JamesGlanville/datalogger/README.md

# Package Condition Tracking System

Data logger designed to track the conditions of a parcel in transit.

It keeps track of:
* Temperature
* Humidity
* Shocks and impacts
* Orientation

Designed and built for SB3 Data Logger project.
