JamesGlanville/datalogger/Reports/Final_Report_Andy.org

** Parcel tracker:

+ http://www.sciencedaily.com/releases/2011/06/110608123143.htm
+ FedEx tracker (Sensor-based-logistics):
  http://www.senseaware.com/
+ who benefits from this type of tracking
  http://www.senseaware.com/who-benefits/
+ worldwide release Nov 2012 - limited in available couriers.
  http://news.van.fedex.com/SenseAware

+ military application:
  http://www.almc.army.mil/alog/issues/JulAug08/enhancelog_w_sensortech.html

+ for container tracking, not parcel based
  http://www.scantec.de/en/knowledge-base/hi-q-news/2010/wireless-sensor-networks-fuer-die-logistik.html

+ Cambridge consultants development
  http://www.cambridgeconsultants.com/news/pr/release/116/en
  
+ Nasa payload tracker (spinoff)
  http://spinoff.nasa.gov/spinoff2000/t1.htm

** RS232 driver
+ http://www.teuniz.net/RS-232/
