JamesGlanville/datalogger/3DAQ/Documentation/cap-humidity-sensor-circuit_files/image001.gif

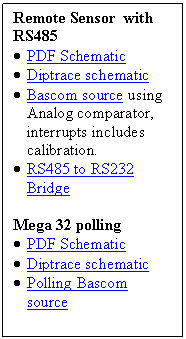
3DAQ/Documentation/cap-humidity-sensor-circuit_files/image001.gif
