JamesGlanville/datalogger/3DAQ/Documentation/cap-humidity-sensor-circuit_files/image003.jpg

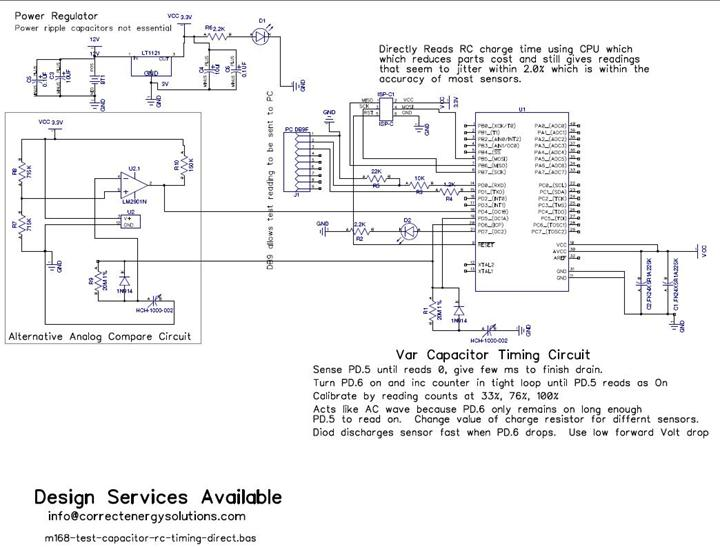
3DAQ/Documentation/cap-humidity-sensor-circuit_files/image003.jpg
