JamesGlanville/datalogger/Reports/humid_calib_freezer.jpg

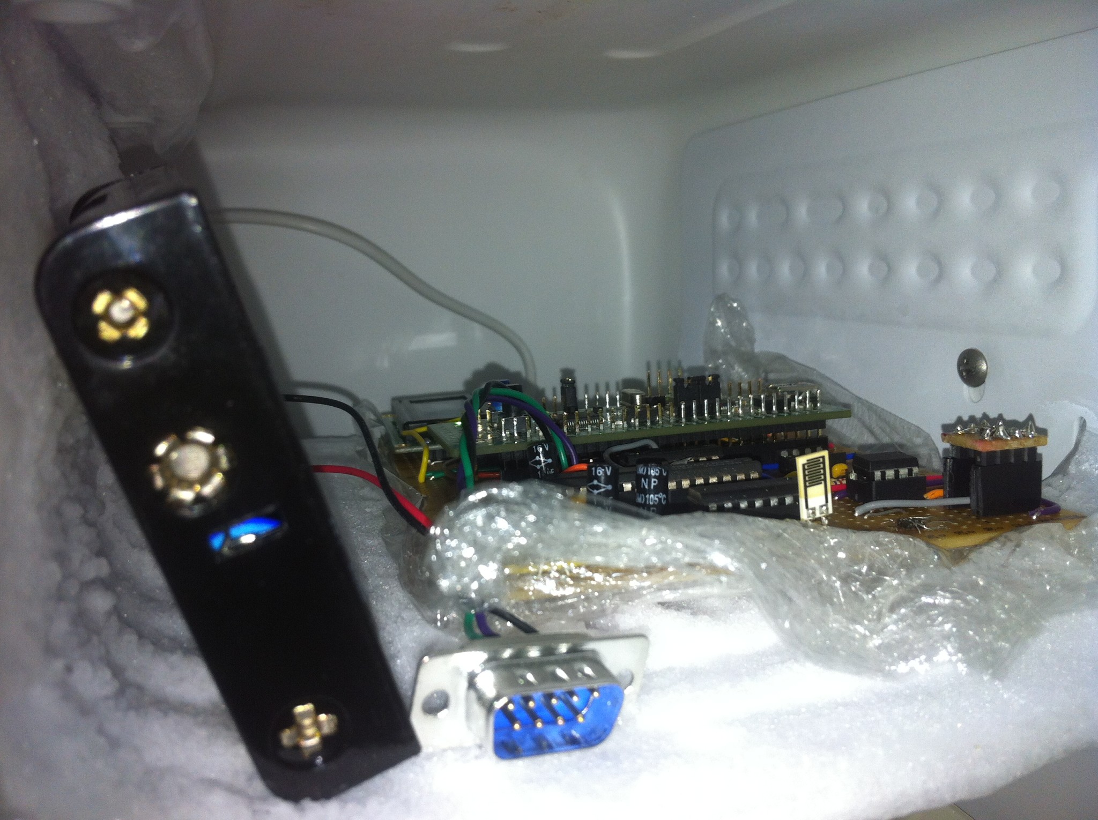
Reports/humid_calib_freezer.jpg
