JamesGlanville/datalogger/Schematics/Thermistor Cond.png

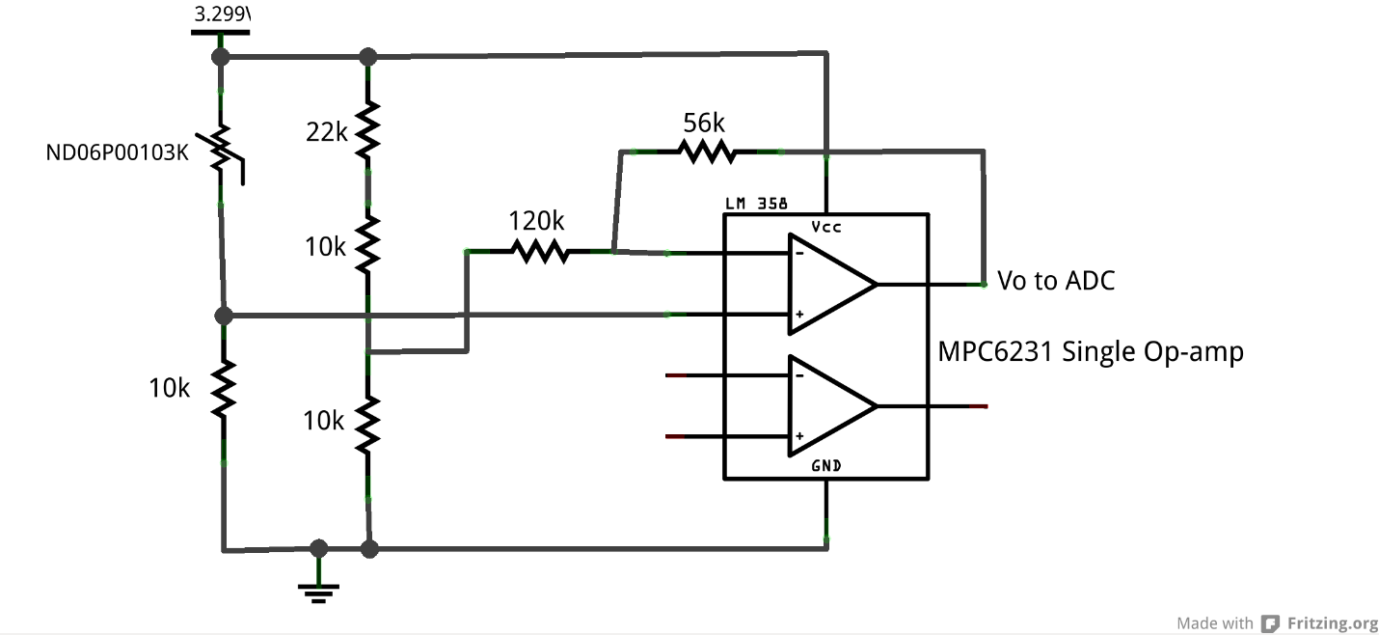
Schematics/Thermistor Cond.png
