JamesGlanville/datalogger/Schematics/Thermistor Conditioning_schem.png

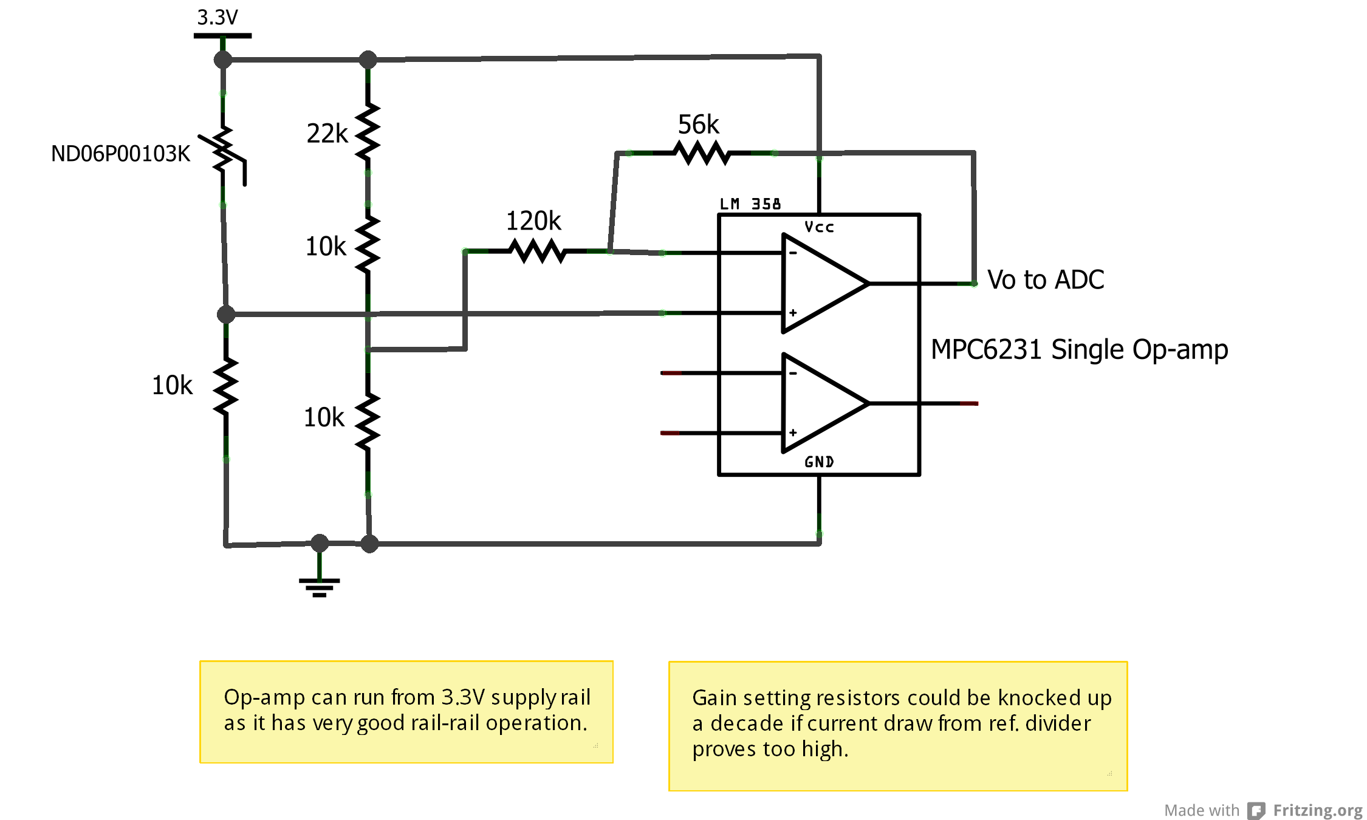
Schematics/Thermistor Conditioning_schem.png
