JamesGlanville/datalogger/(list of files, cad)

Other CAD files:
gui/vc_msw/datalogger/rs232.obj
gui/vc_mswd/datalogger/comms.obj
gui/vc_msw/datalogger/datalogger.obj
gui/vc_mswd/datalogger/rs232.obj
gui/vc_mswd/datalogger/datalogger.obj
