JamesGlanville/datalogger/3DAQ/Documentation/M16_humidity_sensor_HCH-1000-002.dch.pdf

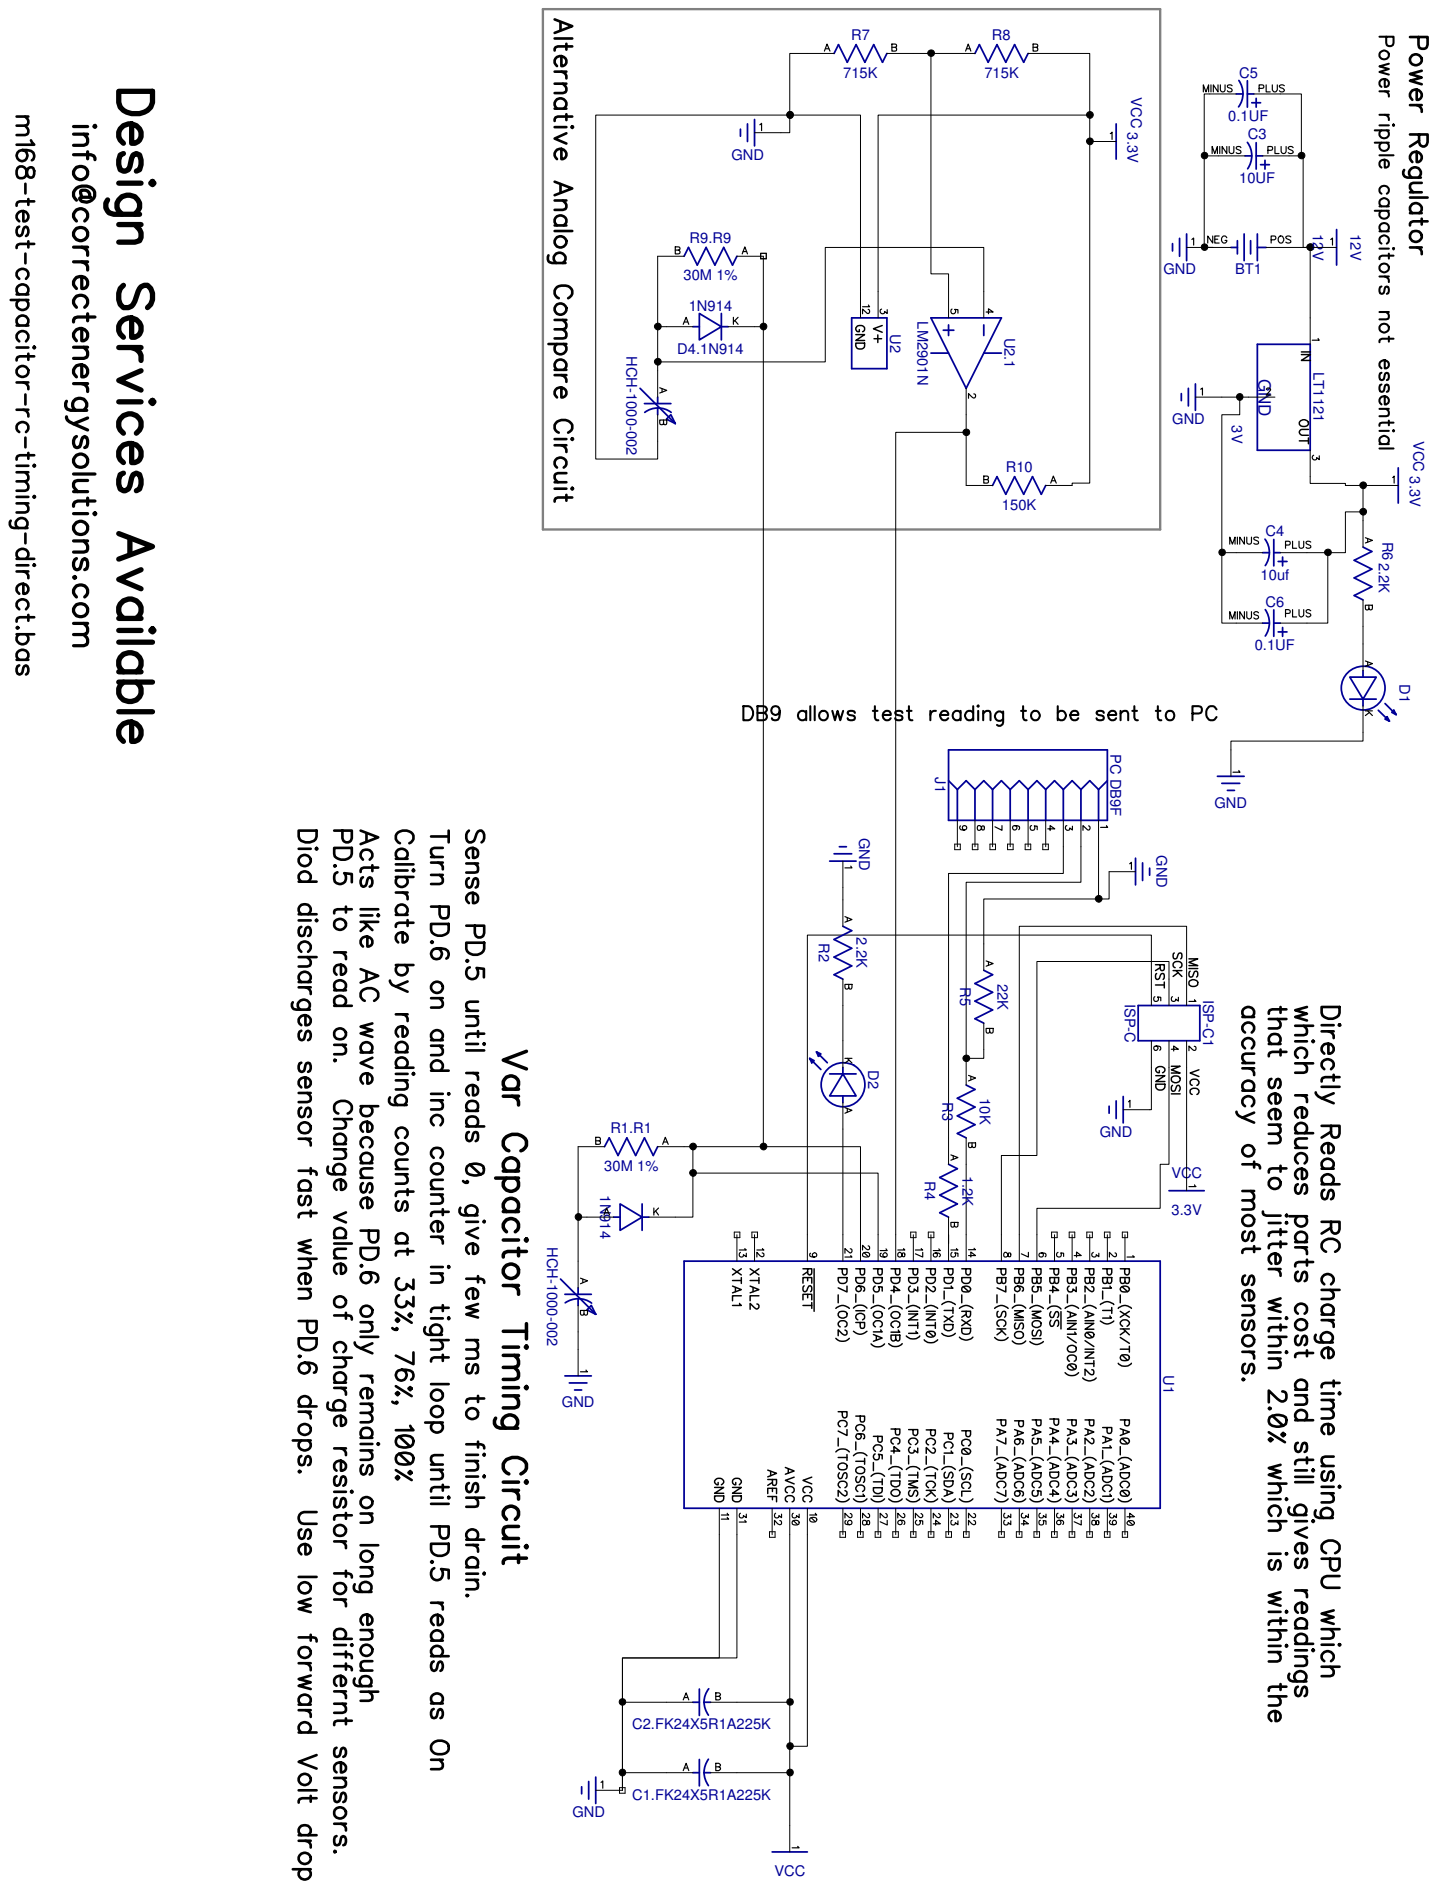
[picture p24: page 1]
