JamesGlanville/datalogger/(list of files, drawings)

Other design files:
Schematics/humiditysensor.fzz
Schematics/i2c.fzz
Schematics/power.fzz
Schematics/Thermistor Conditioning nonotes.fzz
Schematics/Thermistor Conditioning.fzz
