JamesGlanville/datalogger/3DAQ/Firmware/user/src/main.c

#include "stm32F10x.h"
#include "LEDs.h"
#include "UART.h"
#include "ADC.h"
#include "stm32F10x_i2c.h"
#include "stm32f10x_gpio.h"
#include "stm32f10x_rcc.h"
#include "stm32f10x_tim.h"
#include "LCD.h"
#include "humidity.h"
#include "webi2c.h"
#include "timer.h"

#define WAITING		1
#define LOGGING		2
#define UPLOADING	3
#define ERASING		4
#define STREAMING	5

volatile int currentstate=WAITING;

//Hardware:

//LED3 is connected to PC9 (active high)
//Test circuit should have potentiometer connected to PC0 for analogue sampling
//UART TX and RX pins are PA9 and PA10 respectively (with MAX232 interface)

//Firmware:

//User files that can be modified/replaced
//LEDs.c and LEDs.h - functions to control LED on dev board
//ADC.c and ADC.h - functions to initalise ADC and take samples from it
//UART.c and UART.h - functions to initialise and use UART for serial RS232 comms with PC

//Standard includes that should not be modified
//startup_stm32f10x_md_vl.s - startup file (in assembler) that intialises the MCU before it enters main()
//core_cm3.c - definitions specific to the ARM Cortex M3 core
//system_stm32f10.c and stm32f10x.h - functions and definitions specific to the STM32F10x series

//There are also a number of Standard Peripheral Library files that should not be modified (additional SPL files can be included if needed, see "Firmware/lib" folder)

//Software:
//This firmware works with the Labwindows/CVI demonstration appllication sofwtare

//------------------------------------------------------------------------------

//Global variables

//Command from UART
volatile unsigned int LEDbyte=1;

volatile int command_flag;
volatile int value;
volatile int value_received;

//ADC variables
volatile uint8_t new_data;

uint8_t LogBuffer[ENTRYBYTES];

//------------------------------------------------------------------------------

//Function prototypes for functions in main.c file

void check_and_process_received_command(void);

//------------------------------------------------------------------------------

//Main function (execution starts here after startup file)
int main(void)
{
	int i;
	int e;
	uint16_t temperature;

	init_GPIO_pins();
	
	//Short delay during which we can communicate with MCU via debugger even if later user code causes error such as sleep state with no wakeup event that prevents debugger interface working
	//THIS MUST COME BEFORE ALL USER CODE TO ENSURE CHIPS CAN BE REPROGRAMMED EVEN IF THEY GET STUCK IN A SLEEP STATE LATER
	for (i = 0; i < 1000000; i++)
	{
		LED_on();
	}
	
	GPIO_Init_Mode(GPIOA,GPIO_Pin_0,GPIO_Mode_IN_FLOATING); //User button.
	GPIO_Init_Mode(GPIOC,GPIO_Pin_11,GPIO_Mode_IN_FLOATING); //Accelerometer interrupt.
	delay_init();
	LED_off();
	LCDINIT();
	home();
	clear();
	display(); //Surely some of these can be commented out.
	noCursor();
	noBlink();

	standby();

	UART_init();
	humidity_init();
	ADC_init();
	I2C_EEPROM();
	I2C_ACCEL_INIT();
	I2C_EE_LoadConfig();
	logging_timer_init();
	
//	I2C_EE_BufferWrite(Test_Buffer, EEPROM_WriteAddress1, 100);
//I2C_EE_BufferRead(buffer, 0, 100);

	/*while(1){
		if(LEDbyte==512){LEDbyte=1;}
		else {LEDbyte=LEDbyte<<1;}
		setLEDS();
		
	setCursor(0,1);
	temperature=getTemperature();
	writenumber( temperature/100);
	write('.');
	writenumber((temperature/10)%10);
		write(' ');

		write(0xDF);
	write('C');
	setCursor(0,0);
	writenumber(readhumidity(24)); //Needs real temperature
	write(' ');
	write('%');
	write('R');
	write('H');
		delay_ms(50);
		
		check_and_process_received_command();
		
	}*/
	//currentstate=UPLOADING;

	while(1)
	{
		switch (currentstate){
			
		case WAITING:
			if (GPIO_ReadInputDataBit(GPIOA,GPIO_Pin_0)) //Polling is probably ok here, since the loop will be very very fast.
			{
				currentstate=LOGGING;
				clear();
				write('S');
				write('t');
				write('a');
				write('r');
				write('t');
				write('i');
				write('n');
				write('g');
				delay_ms(2000);
				clear();
				I2C_EE_StartLog();
				TIM4->CNT=0;
			}
			break;

		case LOGGING:
			if (GPIO_ReadInputDataBit(GPIOA,GPIO_Pin_0)){currentstate=WAITING;I2C_EE_FinishLog();break;} //Polling is probably ok here, since the loop will be very very fast.
			LEDbyte|= 1<<8;
			setLEDS();
			if (TIM_GetFlagStatus(TIM3, TIM_FLAG_Update) != RESET)
			{
				TIM_ClearFlag(TIM3, TIM_IT_Update);
				temperature = getTemperature();
				LogBuffer[0]=(temperature>>8)&0xFF;
				LogBuffer[1]=temperature&0xFF;
				LogBuffer[2]=readhumidity(LogBuffer[0]);
				I2C_ACCEL_READ();
				I2C_EE_Log(LogBuffer);
				setCursor(0,1);
				writenumber(temperature/100);
				write('.');
				writenumber(temperature%100);
				write(' ');
				write(0xDF);
				write('C');
				write(' ');
				setCursor(0,0);
				writenumber(25); //Needs real temperature
				write(' ');
				write('%');
				write('R');
				write('H');
				write(' ');
				LEDbyte&= ~(1<<8);
				setLEDS();
			}
			break;
		
		case UPLOADING:
			currentstate=WAITING;
			I2C_EE_Upload();
			break;
		
		case ERASING:
			currentstate=WAITING;
			I2C_EE_Erase();
			break;
		
		case STREAMING:
			if (TIM_GetFlagStatus(TIM3, TIM_FLAG_Update) != RESET)
			{
				TIM_ClearFlag(TIM3, TIM_IT_Update);
				temperature = getTemperature();
				LogBuffer[0]=(temperature>>8)&0xFF;
				LogBuffer[1]=temperature&0xFF;
				LogBuffer[2]=readhumidity(LogBuffer[0]);
				I2C_ACCEL_READ();
//				I2C_EE_Log(LogBuffer);
				for (e=0;i<ENTRYBYTES;i++)
				{
					UART_send_byte(LogBuffer[e]);
				}
				setCursor(0,1);
				writenumber(temperature/100);
				write('.');
				writenumber(temperature%100);
				write(' ');
				write(0xDF);
				write('C');
				write(' ');
				setCursor(0,0);
				writenumber(25); //Needs real temperature
				write(' ');
				write('%');
				write('R');
				write('H');
				write(' ');
				LEDbyte&= ~(1<<8);
				setLEDS();
			}
		break;
		}
		
		
	}
}


/*
//------------------------------------------------------------------------------

//Other functions

//Simple function to check for and process one of two received commands from PC via global varoable flags
void check_and_process_received_command(void)
{
	uint16_t ADC_word;
	uint8_t byte1, byte2;
	
	//Check for a receievd (non-zero) command flag from the PC
	if (command_flag == 1)
	{
		//An ADC sample command has been received
		
		//Perform an ADC conversion
		ADC_word = ADC_perform_single_conversion();
		
		//Put the 12-bit result into 2 bytes
		byte1 = (uint8_t)((ADC_word >>8) & 0xFF);
		byte2 = (uint8_t)((ADC_word >>0) & 0xFF);
		
		//Send the message (command flag followed by two bytes with the analogue value)
		UART_send_byte(1);
		UART_send_byte(byte1);
		UART_send_byte(byte2);
		
		//Reset command flag
		command_flag = 0;
	}
	else if (command_flag == 2)
	{
		//An LED command has been received
		
		//Check whether we have also received the value attached to the command (ie on or off)
		if (value_received == 1)
		{
			//Reset command flag
			command_flag = 0;
			
			//Set LED based on value (on or off)
			if (value == 0)
			{
				LED_off();
			}
			else
			{
				LED_on();
			}
		}
	}
	else if (command_flag ==3)
	{
		command_flag=0;
		while (1)
		{
			ADC_word = ADC_perform_single_conversion();
		
			//Put the 12-bit result into 2 bytes
			byte1 = (uint8_t)((ADC_word >>8) & 0xFF);
			byte2 = (uint8_t)((ADC_word >>0) & 0xFF);
		
			//Send the message (command flag followed by two bytes with the analogue value)
			UART_send_byte(1);
			UART_send_byte(byte1);
			UART_send_byte(byte2);
		
		}
	}
}*/
