JamesGlanville/datalogger/3DAQ/Firmware/user/inc/LCD.h

#ifndef LCD_h
#define LCD_h

#include <inttypes.h>

#define HIGH 1
#define LOW 0

// commands
#define LCD_CLEARDISPLAY 0x01
#define LCD_RETURNHOME 0x02
#define LCD_ENTRYMODESET 0x04
#define LCD_DISPLAYCONTROL 0x08
#define LCD_CURSORSHIFT 0x10
#define LCD_FUNCTIONSET 0x20
#define LCD_SETCGRAMADDR 0x40
#define LCD_SETDDRAMADDR 0x80

// flags for display entry mode
#define LCD_ENTRYRIGHT 0x00
#define LCD_ENTRYLEFT 0x02
#define LCD_ENTRYSHIFTINCREMENT 0x01
#define LCD_ENTRYSHIFTDECREMENT 0x00

// flags for display on/off control
#define LCD_DISPLAYON 0x04
#define LCD_DISPLAYOFF 0x00
#define LCD_CURSORON 0x02
#define LCD_CURSOROFF 0x00
#define LCD_BLINKON 0x01
#define LCD_BLINKOFF 0x00

// flags for display/cursor shift
#define LCD_DISPLAYMOVE 0x08
#define LCD_CURSORMOVE 0x00
#define LCD_MOVERIGHT 0x04
#define LCD_MOVELEFT 0x00

// flags for function set
#define LCD_8BITMODE 0x10
#define LCD_4BITMODE 0x00
#define LCD_2LINE 0x08
#define LCD_1LINE 0x00
#define LCD_5x10DOTS 0x04
#define LCD_5x8DOTS 0x00

void complete(void);
void standby(void);
void writenumber(int number);
void LCDINIT(void);
void begin(uint8_t cols, uint8_t lines, uint8_t dotsize);
void delayMicroseconds(int delay);
void write4bits(uint8_t value);
void pulseEnable(void);
void clear(void);
void home(void);
void noDisplay(void);
void display(void);
void noBlink(void);
void blink(void);
void noCursor(void);
void cursor(void);
void scrollDisplayLeft(void);
void scrollDisplayRight(void);
void leftToRight(void);
void rightToLeft(void);
void autoscroll(void);
void noAutoscroll(void);
void command(uint8_t value);
void setCursor(uint8_t col, uint8_t row);
int write(uint8_t value);
void send(uint8_t value, uint8_t mode);
//int defineCharacter(int ascii, int *data);
#endif
