JamesGlanville/datalogger/(commit log)

2013-05-13 added thermistor conditioning circuit
    [Thermistor Conditioning.fzz]
2013-05-16 updated thermistor circuit diagram
    [Thermistor Conditioning.fzz]
2013-05-16 added the code i used on the arduino to test the accelerometer.
2013-05-16 i2c initial schematic
    [i2c.fzz]
2013-05-16 i2c complete. (acc + eeprom)
    [i2c.fzz]
2013-05-16 i2c image
2013-05-16 exported thermistor circuit as png for inserting into report.
2013-05-16 added humidity sensor schem.
    [humiditysensor.fzz]
2013-05-16 Added power schem.
    [power.fzz]
2013-05-17 updated thermistor schematic
    [Thermistor Conditioning nonotes.fzz]
2013-05-18 hopefully lcd interrupt works now.
2013-05-20 Added visual studio 2012 project file, it compiles :)
    [datalogger.obj]
2013-05-20 compiled release datalogger.exe
    [datalogger.obj]
2013-05-20 do all GPIO init in one function, and started writing lookup table for turning on status LEDS
2013-05-20 started porting arduino code to stm32
2013-05-20 Added untested eeprom and accelerometer routines
2013-05-21 started adding uncalibrated and untested humidity sensor code
2013-05-21 accelerometer readings MIGHT print to lcd now
2013-05-21 LEDS work properly now, and displays temp a few times a second to lcd
2013-05-22 Humidity sensor works, displays to lcd
2013-05-22 i2c maaaaaaaby works?
2013-05-23 control buttons added
2013-05-23 timers now work
2013-05-23 fixed typo in include guards
    [comms.h]
2013-05-23 fixed multiple definition bug
    [comms.cpp, comms.h]
2013-05-23 Added humidity sensor lookup table, should now do 2d linear interpolation to get a value, and should only need one calibration point.
2013-05-23 add thermistor calibration code, needs coefficients.
2013-05-24 now displays temperature prettily, and only turns on with pwr button.
2013-05-24 fixed serial port problems
    [comms.obj, datalogger.obj, rs232.obj]
2013-05-24 nearly done, just need to log accel too, as well as leds
2013-05-25 Now should get correct sample period from EEPROM before logging
    [webi2c.c]
2013-05-27 fixed uart interrupt bug.
    [LCD.c, LCD.h, UART.c, main.c, webi2c.c]
2013-05-27 sample rate selection added
2013-05-27 updated initial sample rate
2013-05-27 add send for sample period setting
2013-05-27 structs should work
    [comms.obj, datalogger.obj, rs232.obj]
2013-05-27 fixed constructor variable bug
    [comms.obj, datalogger.obj, rs232.obj]
2013-05-29 added csv button
2013-05-29 csv file writing works
    [comms.obj, datalogger.obj, rs232.obj]
2013-05-29 csv write callback should work
    [comms.obj, datalogger.obj]
2013-05-29 now repaints gui on resize, and starts at a better window size
    [datalogger.obj]
2013-05-29 added test csv file
    [5.csv]
2013-05-29 now correctly prints temperature to 2 dp
    [comms.obj, datalogger.obj, rs232.obj]
2013-05-29 updated csv file format, new file is called poop.csv (sorry)
    [datalogger.obj, poop.csv]
2013-05-29 now says whether it's been shaken or not (not very accurately)
    [datalogger.obj]
2013-05-30 streaming and saving stream to csv works now.
    [comms.obj, datalogger.obj, poop.csv, rs232.obj]
2013-05-30 removed mysterious -1
    [datalogger.obj]
2013-05-30 time now in CSV
    [datalogger.obj]
